gflerm/SWR-Meter/docs/AA-30_ZERO_pcb_bottom.jpg

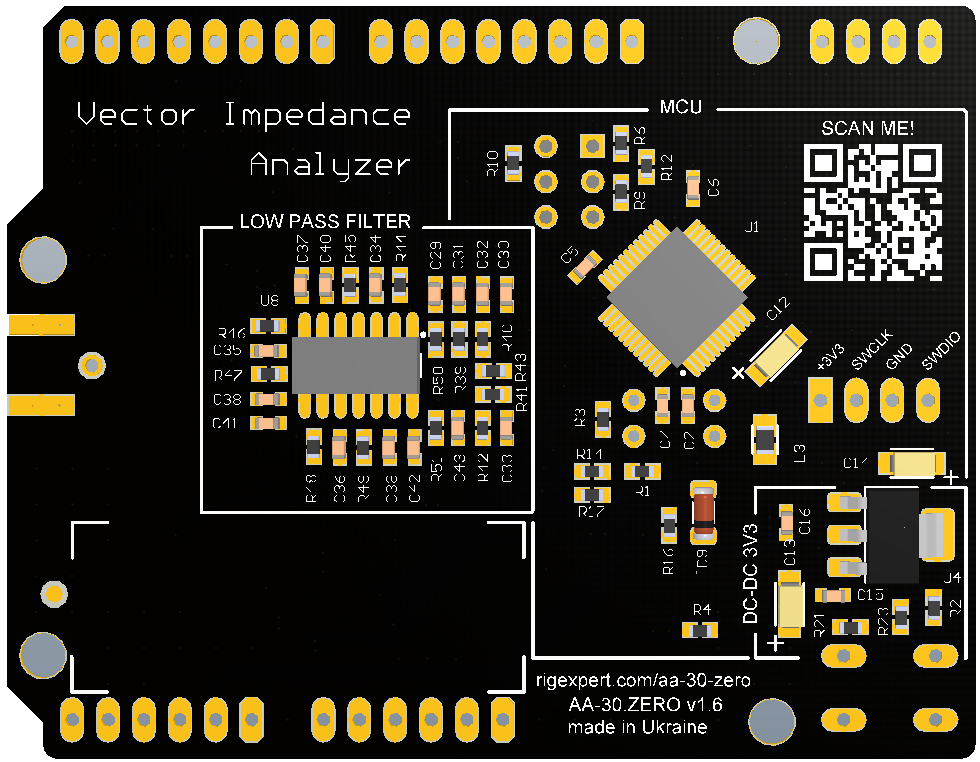
docs/AA-30_ZERO_pcb_bottom.jpg
