gflerm/SWR-Meter/docs/AA-30_ZERO_pcb_top.jpg

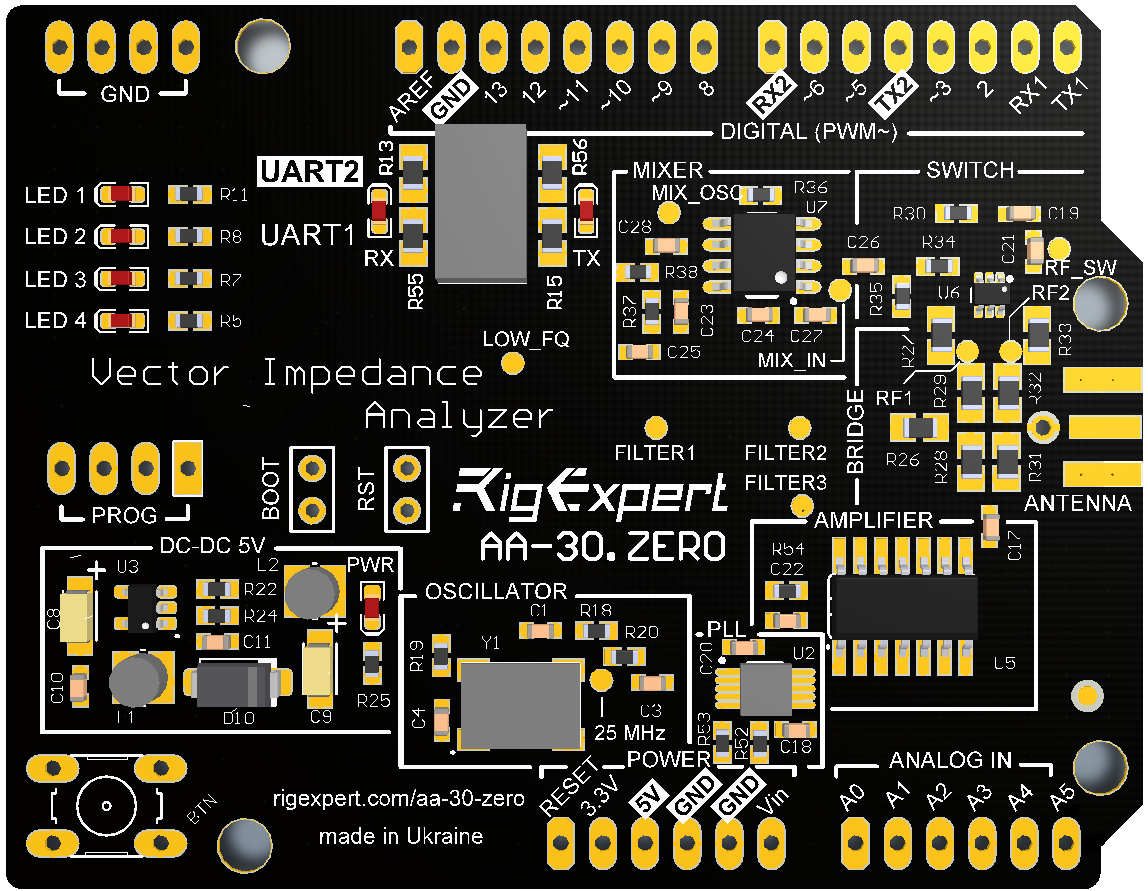
docs/AA-30_ZERO_pcb_top.jpg
