gflerm/SWR-Meter/media/screens/cal_done.png

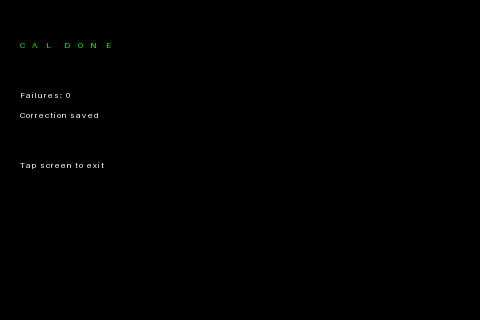
media/screens/cal_done.png
