gflerm/SWR-Meter/media/screens/cal_progress.png

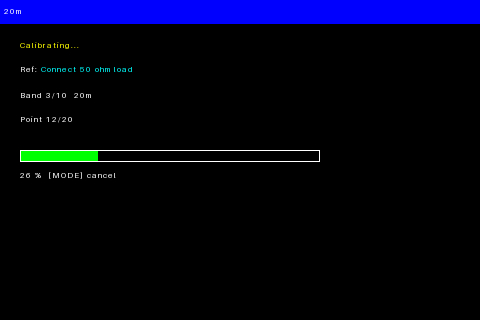
media/screens/cal_progress.png
