gflerm/SWR-Meter/media/screens/curve.png

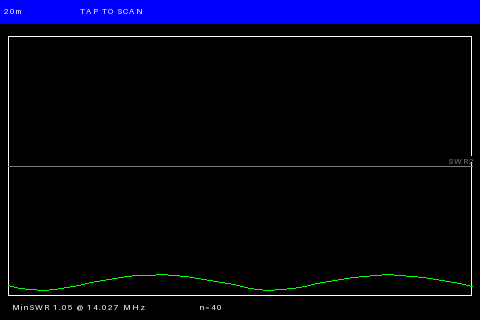
media/screens/curve.png
