gflerm/SWR-Meter/media/screens/scanning.png

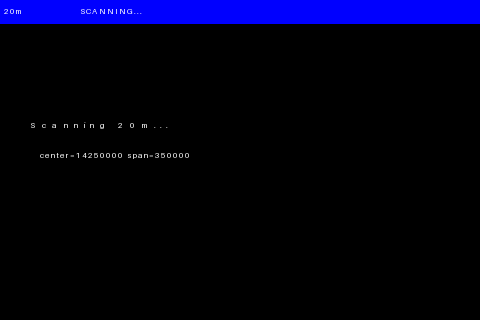
media/screens/scanning.png
