gflerm/SWR-Meter/media/screens/welcome.png

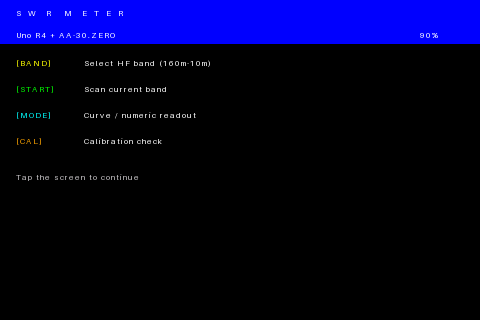
media/screens/welcome.png
