gflerm/SWR-Meter/docs/display_wiring.pdf

# Uno R4 Minima → LCDWIKI MSP4021 4.0" TFT · LiPower battery shield

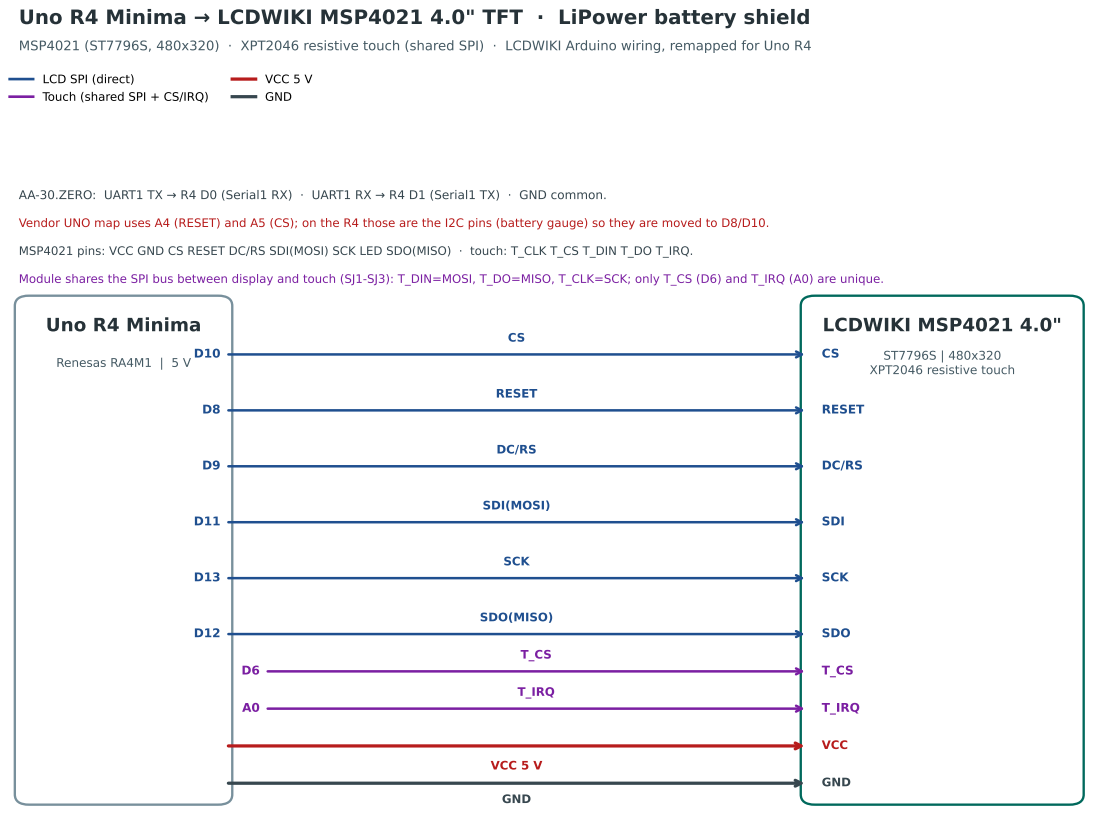
[picture p11: page 1]

MSP4021 (ST7796S, 480x320) · XPT2046 resistive touch (shared SPI) · LCDWIKI Arduino wiring, remapped for Uno R4

LCD SPI (direct)
Touch (shared SPI + CS/IRQ)

AA-30.ZERO: UART1 TX → R4 D0 (Serial1 RX) · UART1 RX → R4 D1 (Serial1 TX) · GND common.

Vendor UNO map uses A4 (RESET) and A5 (CS); on the R4 those are the I2C pins (battery gauge) so they are moved to D8/D10.

MSP4021 pins: VCC GND CS RESET DC/RS SDI(MOSI) SCK LED SDO(MISO) · touch: T_CLK T_CS T_DIN T_DO T_IRQ.

Module shares the SPI bus between display and touch (SJ1-SJ3): T_DIN=MOSI, T_DO=MISO, T_CLK=SCK; only T_CS (D6) and T_IRQ (A0) are unique.
