gflerm/SWR-Meter/graphs/12m.pdf

3.00

# RigExpert AA-30.ZERO — Antenna Analyzer Sweep

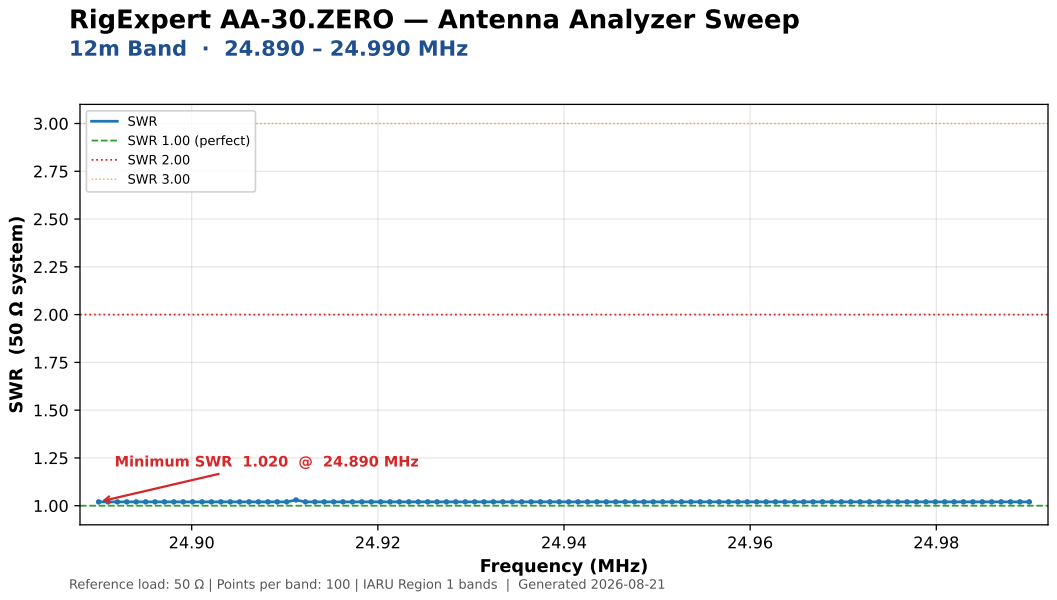
[picture p13: page 1]
Frequency (MHz); SWR (50; Ω system); Minimum; SWR 1.020 @ 24.890; MHz; 12m Band · 24.890 – 24.990 MHz

SWR
SWR 1.00 SWR 2.00 | (perfect)

SWR 3.00

Reference load: 50 Ω | Points per band: 100 | IARU Region 1 bands | Generated 2026-08-21
