gflerm/SWR-Meter/graphs/15m.pdf

3.00

# RigExpert AA-30.ZERO — Antenna Analyzer Sweep

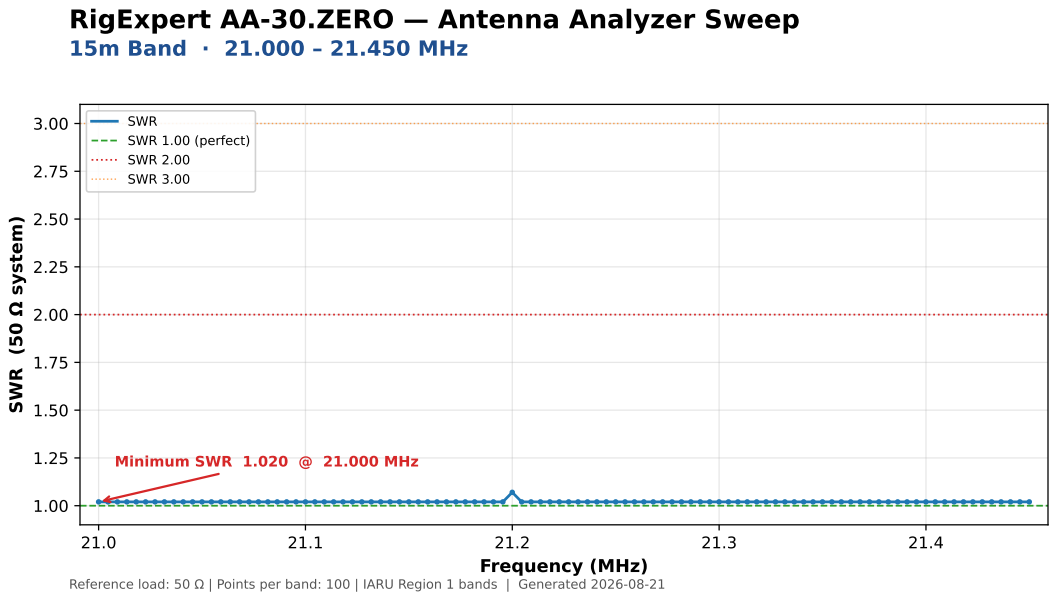
[picture p14: page 1]
Frequency (MHz); SWR (50; Ω system); 15m Band · 21.000 – 21.450 MHz

SWR
SWR 1.00 (perfect) SWR 2.00

SWR 3.00

Minimum SWR 1.020 @ 21.000 MHz

Reference load: 50 Ω | Points per band: 100 | IARU Region 1 bands | Generated 2026-08-21
