gflerm/SWR-Meter/graphs/160m.pdf

3.00

# RigExpert AA-30.ZERO — Antenna Analyzer Sweep

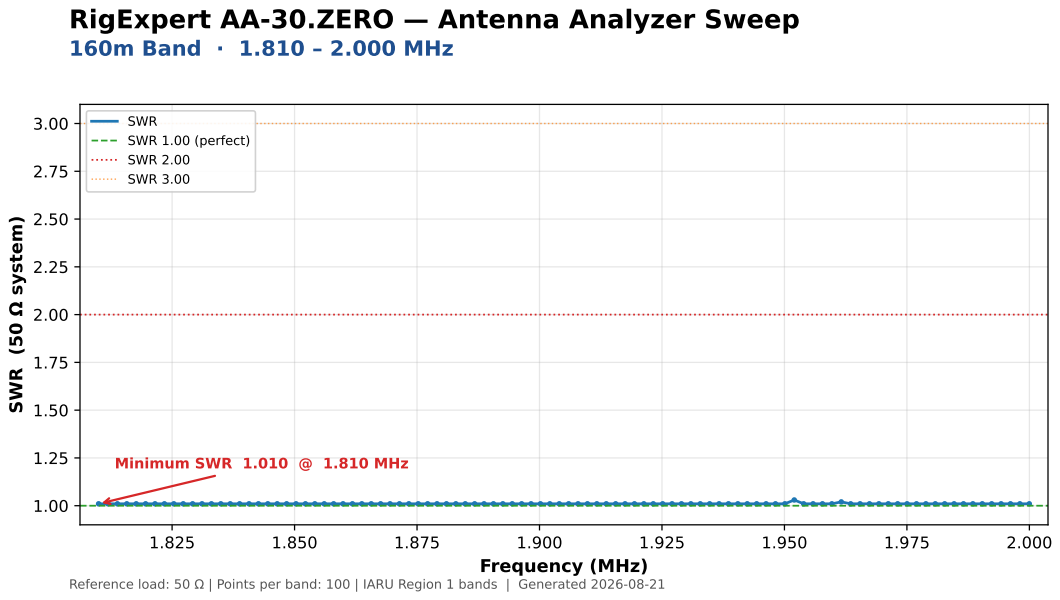
[picture p15: page 1]
Frequency (MHz); SWR (50; Ω system); Minimum SWR 1.010; @ 1.810 MHz; 160m Band · 1.810 – 2.000 MHz

SWR
SWR 1.00 (perfect) SWR 2.00

SWR 3.00

Reference load: 50 Ω | Points per band: 100 | IARU Region 1 bands | Generated 2026-08-21
