gflerm/SWR-Meter/graphs/60m.pdf

3.00

# RigExpert AA-30.ZERO — Antenna Analyzer Sweep

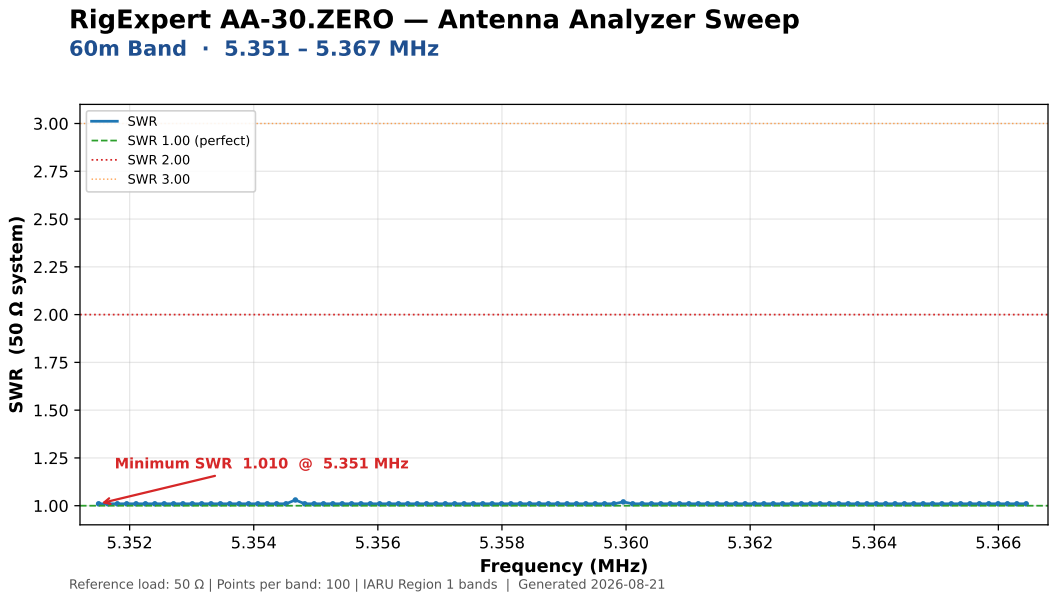
[picture p20: page 1]
Frequency (MHz); SWR (50; Ω system); 60m Band · 5.351 – 5.367 MHz

SWR
SWR 1.00 (perfect) SWR 2.00

SWR 3.00

Minimum SWR 1.010 @ 5.351 MHz

Reference load: 50 Ω | Points per band: 100 | IARU Region 1 bands | Generated 2026-08-21
