gflerm/SWR-Meter/graphs/80m.pdf

3.00

# RigExpert AA-30.ZERO — Antenna Analyzer Sweep

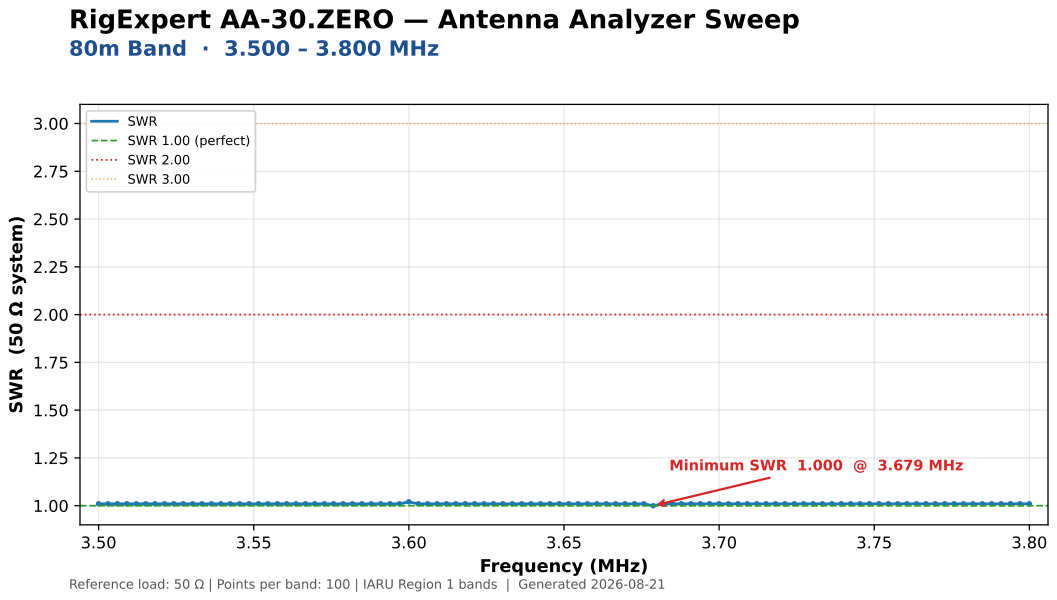
[picture p21: page 1]
Frequency (MHz); SWR (50; Ω system); Minimum SWR 1.000 @; 3.679 MHz; 80m Band · 3.500 – 3.800 MHz

SWR
SWR 1.00 (perfect) SWR 2.00

SWR 3.00

Reference load: 50 Ω | Points per band: 100 | IARU Region 1 bands | Generated 2026-08-21
