gflerm/SWR-Meter/graphs/AA-30_ZERO_all_bands.pdf

# RigExpert AA-30.ZERO

# Antenna Analyzer — Full Band Sweep

## SWR vs Frequency · 160 m → 10 m · 50 Ω reference load

Band | Frequency Range (MHz) | Min SWR | at (MHz)
160m | 1.810 – 2.000 | 1.01 | 1.810
80m | 3.500 – 3.800 | 1.00 | 3.679
60m | 5.351 – 5.367 | 1.01 | 5.351
40m | 7.000 – 7.200 | 1.01 | 7.000
30m | 10.100 – 10.150 | 1.01 | 10.100
20m | 14.000 – 14.350 | 1.01 | 14.000
17m | 18.068 – 18.168 | 1.01 | 18.072
15m | 21.000 – 21.450 | 1.02 | 21.000
12m | 24.890 – 24.990 | 1.02 | 24.890
10m | 28.000 – 29.700 | 1.02 | 28.000

### Reference load: 50 Ω | Points per band: 100 | IARU Region 1 bands

Generated 2026-08-21

3.00

# RigExpert AA-30.ZERO — Antenna Analyzer Sweep

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

SWR
SWR 1.00 (perfect) SWR 2.00

SWR 3.00

Reference load: 50 Ω | Points per band: 100 | IARU Region 1 bands | Generated 2026-08-21

3.00

# RigExpert AA-30.ZERO — Antenna Analyzer Sweep

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

SWR
SWR 1.00 (perfect) SWR 2.00

SWR 3.00

3.00

# RigExpert AA-30.ZERO — Antenna Analyzer Sweep

SWR (50; Ω system); 60m Band · 5.351 – 5.367 MHz

SWR
SWR 1.00 (perfect) SWR 2.00

SWR 3.00

Minimum SWR 1.010 @ 5.351 MHz

3.00

# RigExpert AA-30.ZERO — Antenna Analyzer Sweep

SWR (50; Ω system); 40m Band · 7.000 – 7.200 MHz

SWR
SWR 1.00 (perfect) SWR 2.00

SWR 3.00

Minimum SWR 1.010 @ 7.000 MHz

3.00

# RigExpert AA-30.ZERO — Antenna Analyzer Sweep

SWR (50; Ω system); 30m Band · 10.100 – 10.150 MHz

SWR
SWR 1.00 (perfect) SWR 2.00

SWR 3.00

Minimum SWR 1.010 @ 10.100 MHz

3.00

# RigExpert AA-30.ZERO — Antenna Analyzer Sweep

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

SWR
SWR 1.00 (perfect) SWR 2.00

SWR 3.00

3.00

# RigExpert AA-30.ZERO — Antenna Analyzer Sweep

SWR (50; Ω system); 17m Band · 18.068 – 18.168 MHz

SWR
SWR 1.00 (perfect) SWR 2.00

SWR 3.00

Minimum SWR 1.010 @ 18.072 MHz

3.00

# RigExpert AA-30.ZERO — Antenna Analyzer Sweep

SWR (50; Ω system); 15m Band · 21.000 – 21.450 MHz

SWR
SWR 1.00 (perfect) SWR 2.00

SWR 3.00

Minimum SWR 1.020 @ 21.000 MHz

3.00

# RigExpert AA-30.ZERO — Antenna Analyzer Sweep

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

SWR
SWR 1.00 SWR 2.00 | (perfect)

SWR 3.00

3.00

# RigExpert AA-30.ZERO — Antenna Analyzer Sweep

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

SWR
SWR 1.00 (perfect) SWR 2.00

SWR 3.00
