gflerm/SWR-Meter/src/config.h

// config.h
//
// Shared hardware pin map, build-time constants, and data types for the
// AA-30.ZERO SWR meter. Included by every translation unit; contains no state
// and no hardware objects, so it is safe to include from many .cpp files.
//
// 2024, opencode AI

#ifndef CONFIG_H
#define CONFIG_H

#include <Arduino.h>

// --- AA-30 ZERO UART (interface UART1, hardware Serial1: RX = D0, TX = D1)
#define AA_PORT Serial1
// PC console / telemetry port. 115200 keeps AA-30 -> PC from being the
// bottleneck while streaming many measurement points.
#define PC_BAUD 115200

// --- Display: LCDWIKI MSP4021 4.0" 480x320 TFT (ST7796S), 4-wire SPI. ---
//     Driven via TFT_eSPI, whose pin definitions are set in platformio.ini
//     (build_flags): SPI MOSI=11, SCK=13, MISO=12, CS=D10, DC=D9, RST=D8,
//     LED=D7, touch CS=D6. The module shares the SPI bus between the display
//     and the XPT2046 touch (SJ1-SJ3 jumpered). The vendor UNO map uses A4/A5
//     (RESET/CS); on the R4 those are the I2C bus (battery gauge), so the pins
//     are moved to D8/D10. Native panel is 320x480 (portrait); rotated to
//     480x320 landscape.
#define TFT_W    480  // landscape width after setRotation(1)
#define TFT_H    320  // landscape height after setRotation(1)

// --- LiPower MAX17043 low-battery alert (active-low) on D2 ---------------
#define BAT_ALERT_PIN  2     // LiPower MAX17043 ALRT (active-low)
#define BAT_LOW_PCT    32    // warn when battery drops to this % (matches alert)

// --- AA-30 signal analysis
#define Z0 50.0f                 // system impedance for SWR math (default 50 ohm)

// Validation limits for rejecting bogus readings (NaN/Inf or absurd magnitudes).
#define MAX_RESISTANCE 1000000.0f  // ohms
#define MAX_REACTANCE  1000000.0f  // ohms
#define MAX_SWR        100.0f      // physically impossible above this for HF

// Fitted line buffer for AA-30 ASCII output (one CSV line at a time).
#define LINE_BUF 96

// Device-side max points retained for display; reset on every scan.
#define MAX_POINTS 256
#define POINTS_PER_SCAN 100   // points requested per band (fits in MAX_POINTS)

// Touch hold time before a press is registered, in ms (simple debounce).
#define TOUCH_DEBOUNCE_MS 40

// If a scan or calibration sweep receives no valid data within this time,
// abort back to IDLE so the unit never hangs waiting on a silent analyzer.
#define SCAN_TIMEOUT_MS 8000

// ---- Calibration wizard / correction table ---------------------------
// The wizard sweeps every HF band against reference loads, then stores a
// per-band per-point R/X offset table in EEPROM. Normal sweeps apply the
// nearest stored offset to correct the analyzer readings.
#define CAL_PTS_PER_BAND 20   // sweep points per band during calibration
#define CAL_EEPROM_MAGIC 0x4C4E31  // "CAL1" marker
#define CAL_EEPROM_ADDR  0

// Corrections applied after a band sweep, before the band is accepted.
#define CAL_MAX_RETRIES 3   // single-point re-measures per bogus slot
#define CAL_PASS_PCT   90   // minimum % of valid points to accept a band

// ======================================================================
// DATA TYPES
// ======================================================================

struct Measurement {
  float freqMHz; // frequency (MHz)
  float r;       // series resistance (ohm)
  float x;       // series reactance (ohm)
  float swr;     // computed SWR
  bool  valid;   // passed all checks
};

// Result of a calibration / performance-check measurement.
struct CalResult {
  bool         valid;
  float        r, x, swr;
  float        devPct;   // % deviation from the reference (resistive refs)
  bool         pass;
  const char*  refName;
};

enum SystemState {
  STATE_WELCOME,
  STATE_IDLE,
  STATE_CALIBRATE,
  STATE_CAL_DONE,
  STATE_SCANNING,
  STATE_DISPLAYING
};

enum DisplayMode {
  MODE_CURVE,   // SWR vs frequency graph
  MODE_NUMERIC  // big R / X / SWR numbers
};

// IARU Region 1 HF amateur band plan (band name, low edge Hz, high edge Hz).
typedef struct {
  const char* name;
  uint32_t    low;
  uint32_t    high;
} Band;

const Band BANDS[] = {
  { "160m",  1810000,  2000000 },
  { "80m",   3500000,  3800000 },
  { "60m",   5351500,  5366500 },
  { "40m",   7000000,  7200000 },
  { "30m",  10100000, 10150000 },
  { "20m",  14000000, 14350000 },
  { "17m",  18068000, 18168000 },
  { "15m",  21000000, 21450000 },
  { "12m",  24890000, 24990000 },
  { "10m",  28000000, 29700000 },
};

#define NUM_BANDS (sizeof(BANDS) / sizeof(BANDS[0]))

// One correction entry: an additive offset to apply at a given frequency.
typedef struct {
  float freqMHz;  // measurement frequency (MHz)
  float rCorr;    // add to measured R to get corrected R
  float xCorr;    // add to measured X to get corrected X
  bool  valid;    // this point produced a physically plausible reading
} CalPoint;

// Correction table for one band (CAL_PTS_PER_BAND entries).
typedef struct {
  bool     valid;
  uint8_t  count;
  CalPoint pts[CAL_PTS_PER_BAND];
} CalBand;

// Calibration wizard phases (in order). Only the 50 ohm phase matters: it
// builds and stores the correction table. SHORT/OPEN were verification-only
// (no correction, no EEPROM write), so they were removed to keep the wizard
// to a single plug / pass.
enum CalPhase {
  CAL_PHASE_50     // sweep 50 ohm -> build offsets
};
#define NUM_CAL_PHASES 1

#endif // CONFIG_H
