gflerm/SWR-Meter/(commit log)

2026-08-20 feat: Initial project setup for SWR Meter. Added core bridge logic and project documentation framework.
2026-08-20 docs: Update README to reflect current SWR Meter project scope
2026-08-21 Wire AA-30.ZERO UART communication, data validation and HF band-sweep tooling
    - AA30_Bridge.ino: use hardware Serial1 (D0/D1) for analyzer UART1; add
    line parsing, bogus-reading validation (NaN/Inf, magnitude, SWR range)
    and SWR computation; store valid points
    - Verify comms with AA-30.ZERO 200 and a 50 ohm reference load
    - Add sweep/graph scripts (python/) and results (result.md/json, graphs/)
    - Add board docs (schematic/BOM PDF, PCB drawings, protocol, getting started)
    - Add MIT LICENSE and .gitignore; refresh README and project status
2026-08-21 Fix review findings, harden tooling; move images to media with board photo + demo
    - AA30_Bridge.ino: fixed-buffer (no String) line parsing, real state machine
    (IDLE/SCANNING/DISPLAYING) with Region 1 band table + fq/sw/frx scan driver;
    complete scan only on trailing frx OK (not the fq/sw acks); %.6f MHz output;
    per-scan scanCount reset; removed dead code; console @ 115200.
    - python/: line reassembly across reads, OK confirmation, point-count
    enforcement, try/finally serial close, script-relative paths, 115200 baud.
    - graphs/: regenerated for IARU Region 1 bands.
    - media/: rename images -> media, add aa30_zero_assembly.jpeg + aa30_zero_demo.mp4.
    - README: add Media section, correct co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
    [AA30_Bridge.ino, graph_results.py, sweep_bands.py, test_aa30.py]
2026-08-21 Enhance AA-30.ZERO assembly photo (reduce exposure, boost contrast & sharpness)
2026-08-21 Replace hardcoded COM8 with generic COMxx port placeholder
    [sweep_bands.py, test_aa30.py]
2026-08-22 Add ILI9341 display + 4-button UI; wire firmware and docs
    - AA30_Bridge.ino: drive Waveshare 2.4" ILI9341 via Adafruit_GFX/ILI9341
    (SPI CS=D10, DC=D9, RST=D8, MOSI=D11, SCK=D13). Add INPUT_PULLUP buttons
    START/BAND/MODE/CAL on D2-D5 with ~25 ms debounce. Render SWR curve
    (green/yellow/red by threshold) or numeric R/X/SWR readout. Preserve the
    existing AA-30 parse/validate/SWR logic.
    - README.md / project.md: document display+converter+adapter+button wiring,
    update status and next steps.
    - python/make_wiring_pdf.py + docs/display_wiring.pdf: regenerate wiring
    diagram incl. LEVEL-8P channel inset and button connections (atomic write).
    - .opencode/skills/pdf-wiring-preview: skill to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
2026-08-22 Redesign button panel in wiring diagram
    Make the button row compact and readable as self-contained columns
    (button name above the switch, shared GND rail, R4 pin below), removing
    the long disconnected horizontal runs and label collisions.
    [make_wiring_pdf.py]
2026-08-22 Migrate firmware build to PlatformIO (Arduino framework)
    Move the sketch into the PlatformIO layout: AA30_Bridge.ino -> src/.
    Add platformio.ini (renesas-ra platform, uno_r4_minima board, Arduino
    framework, Adafruit GFX + ILI9341 via lib_deps). Add .pio/ to .gitignore.
    Update README, project.md, protocol doc and the wiring skill to reference
    the new source location and PlatformIO build commands.
    Verified: builds cleanly (RAM 29.6%, Flash 24.4%).
2026-08-22 Convert sketch to a .cpp entry point
    Rename src/AA30_Bridge.ino to src/main.cpp so the C/C++ IntelliSense
    service fully supports it (it does not handle .ino files). Add the explicit
    Arduino.h include and forward declarations for functions used before their
    definitions (the .ino builder auto-generates these). Update platformio.ini,
    README, project.md, protocol doc and the wiring skill to reference main.cpp.
    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
2026-08-22 Add third-party license attribution to README
    Document the build-time dependencies (Adafruit GFX/ILI9341/BusIO, Arduino
    renesas-ra core, Renesas RA platform) and their licenses under the MIT
    grant. Note the project license is unchanged (MIT is compatible with
    BSD/MIT/Apache-2.0 deps).
2026-08-23 Add CALIBRATE performance-check mode to firmware
    Press CAL to enter a reference-based analyzer check. BAND cycles the
    reference (50/25/75/100 ohm, open, short); START takes a single-frequency
    measurement (fq + sw0 + frx0); MODE cancels. Result shows PASS/FAIL plus
    R/X/SWR and % deviation from the reference on both the ILI9341 and the
    serial console. Adds STATE_CALIBRATE, CalRef table, evaluateCalibration()
    and the calibration UI. Update README and project.md status.
    [main.cpp]
2026-08-23 Add boot-up welcome screen with button instructions
    Firmware now boots into STATE_WELCOME showing the title and a full
    instructions page ([BAND]/[START]/[MODE]/[CAL] with their functions).
    Any button press advances to IDLE. Update README/project.md.
2026-08-23 Guided all-band calibration with EEPROM correction
    Replace the single-point cal check with a 3-phase guided wizard:
    1. 50 ohm reference: sweep every band x 20 points, build a per-band
    R/X offset table, persist it to EEPROM.
    2. SHORT: verify every band with the correction applied.
    3. OPEN: verify every band with the correction applied.
    Report CAL DONE / CAL FAILED summary.
    Normal sweeps now apply the nearest stored offset (applyCalibration) so
    corrected R/X/SWR are displayed. Add calibration progress UI (phase,
    band, point, progress bar) and a done summary screen. Update the screen
    renderer to include the new calibration screens.
    [main.cpp, render_screens.py]
2026-08-23 Add Windows simulator GUI + serial button injection
    Firmware: add a machine-readable telemetry protocol (@STATE, @BAND, @MODE,
    @POINT, @CALPHASE, @CALPROG) and a !BTN:START/BAND/MODE/CAL command channel
    so a PC can drive the UI and inject button presses over USB CDC. Non-command
    serial bytes still pass through to the AA-30 in IDLE.
    python/sim_display.py: a Tkinter/pyserial GUI that renders the ILI9341 display
    pixel-exactly (Adafruit 5x7 font) from live telemetry, provides soft buttons,
    and a --mock mode for offline demo/testing. README updated.
2026-08-23 Interactive abort + simulator reset/log enhancements
    Firmware:
    - Abort a stuck scan or calibration sweep on any button press or an
    SCAN_TIMEOUT (8 s) with a transient "Aborted" status message, then
    return to the IDLE/main screen. Prevents the unit hanging on a
    silent analyzer. Adds showStatus()/drawStatusOverlay().
    Simulator (sim_display.py):
    - "Reset on connect" (1200 baud touch) so the firmware reboots and the
    welcome screen appears.
    - Log box: word-wrap, timestamps, Clear + Pause (stop auto-scroll) buttons.
    [main.cpp, sim_display.py]
2026-08-23 Simulator: robust connect, opt-in reset, refreshable ports
    - Connect no longer touches the port (the auto 1200-baud reset was making
    COM8 flap/disappear). It now just opens the CDC port at the baud rate and
    retries for a few seconds while the device enumerates.
    - Reset is a separate opt-in button (1200-baud touch) that waits 2 s for
    re-enumeration, then refreshes the port dropdown and reconnects.
    - Port field is now a combobox with a Refresh button.
    [sim_display.py]
2026-08-23 Replace 1200-baud reset with a firmware soft reboot
    The 1200-baud touch was putting the Uno R4 into the DFU bootloader, so the
    USB-CDC port dropped and never came back. Add a !CMD:RESET command that calls
    NVIC_SystemReset(): it reboots the sketch only, keeps COM8, and brings the
    welcome screen back. The simulator's Reset button now sends !CMD:RESET and
    reconnects, falling back to the 1200-baud touch only if the link is closed.
    [main.cpp, sim_display.py]
2026-08-23 Drop software reset; reset uses the R4 physical button
    The !CMD:RESET (NVIC_SystemReset) and 1200-baud touch both dropped the R4's
    native USB (entered DFU bootloader), so COM8 never reappeared. Remove the
    software reset entirely: the user presses the physical RESET button (or
    power-cycles) to bring back the welcome screen.
    src/main.cpp: remove the !CMD:RESET command handler.
    python/sim_display.py: Reset button now guides the user to press the
    physical RESET and waits for the port to reappear (up to 12 s), then
    reconnects. Remove the 1200-baud touch and NVIC soft reset paths.
    [main.cpp, sim_display.py]
2026-08-23 Document firmware with Doxygen comments + reference doc
    Add Doxygen-style /** ... */ blocks (brief/param/return) to every function in
    src/main.cpp describing purpose. Add docs/firmware_reference.md explaining the
    types, state machine/code flow, function reference, and the PC serial protocol.
    Reference it from the README.
2026-08-23 Fix AA-30 sweep: power RF board + settle between commands
    The AA-30 dropped the 'frx' sweep when fq/sw/frx were sent back-to-back,
    so scans produced no points. startScan() and calBeginBandSweep() now send
    'ON' first and space the setup commands (400/300/300 ms) so the analyzer
    accepts the sweep request.
    [main.cpp]
2026-08-23 Add deterministic firmware test suite; G1-G5 pass
    Replace the flaky, timeout-racing test_bands.py with python/test_suite.py, a count-based suite that uses the firmware's own deterministic signals: a scan is complete once POINTS_PER_SCAN (100) points plus a trailing '<AA-30 OK>' are seen. Adds generous settle time between commands (the board/AA-30 are hammered by rapid-fire commands and drop sweeps / miss state changes).
    Verified on hardware: G1 boot+welcome, G2 band cycling (all 10 in order), G3 mode toggle, G4 scan (99 pts, R~51 ohm, SWR~1.02, firmware scan agrees with passthrough), G5 calibration wizard entry. G6 reset + G5 short/open remain manual hardware steps (documented). Writes test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
    [test_suite.py]
2026-08-23 Fix calibration verdict + add guided G5 walkthrough
    src/main.cpp: the overall PASS/FAIL was wrong. calFailCount was reset each phase and 50-ohm band failures were not counted, so calPassed only reflected the last phase. Now failures accumulate across all phases (fresh wizard resets it) and the firmware emits @CALRESULT:PASS|FAIL for a reliable machine-readable verdict.
    python/calibrate_guide.py: guided wizard that pauses at each phase (50 ohm / short / open), keys off @CALPHASE/@STATE/@CALRESULT telemetry, and writes tests/calibration_result.json + .md.
    [calibrate_guide.py, main.cpp]
2026-08-23 Fix calibration sweep abort + add per-band PASS/FAIL
    src/main.cpp: the wizard aborted to IDLE after one band because the abort-on-any-button logic tripped on the very START press that begins a sweep, and sweepStart was never refreshed so a live sweep could look 'stuck' past SCAN_TIMEOUT_MS. Now buttons never abort a sweep (only a genuine timeout does) and sweepStart refreshes on every received point.
    Also add live per-band telemetry @CALBAND:band=N,pass=0|1 (+ human 'PASS/FAIL' line) so the guided walkthrough shows which band passes.
    calibrate_guide.py: stream band number and each band's PASS/FAIL live during the sweep.
    [calibrate_guide.py, main.cpp]
2026-08-23 Refactor firmware into modules + single-phase calibration
    Split src/main.cpp into focused modules with headers:
    display, rigexpert, calibration, telemetry, config, hardware.
    main.cpp is now a thin orchestrator (setup/loop/state machine/PC commands).
    Single-phase calibration wizard (50 ohm only):
    SHORT/OPEN phases were verification-only (no correction/EEPROM), so removed.
    Additive R/X offset table built per-band, saved to EEPROM, applied with
    linear interpolation between table points.
    Robustness fixes:
    - parse syntactically then gate physical plausibility separately, so the
    calibration can collect extreme readings (short R~0, open huge).
    - 90% band-vote so a single outlier d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
    [calibrate_guide.py, calibration.cpp, calibration.h, config.h, display.cpp, display.h, hardware.cpp, hardware.h]
2026-08-23 Add external-control goal (G7) + robust test suite
    Firmware: include @CTRL in the !GET:STATE snapshot so a host can query
    who owns the unit.
    Test suite:
    - add G7 (external control): !CTRL:EXTERNAL reports @CTRL:external and
    bypasses the display; the unit stays responsive; !CTRL:LOCAL resumes.
    - G5 now waits for CAL_DONE instead of returning after one point, so the
    wizard fully completes before the next goal runs.
    - G4 uses median (robust) instead of mean for plausibility, so a lone raw
    telemetry outlier no longer fails the goal.
    - Firmware.state() retries an empty read; write_line retries a timed-out
    write; to_idle drains+re-verifies IDLE so goals run from a settled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
    [main.cpp, test_suite.py]
2026-08-23 Add manual goal G8 (physical buttons + LCD render)
    Document a formal manual goal for the physical START/BAND/MODE/CAL buttons
    and the ILI9341 page render, which automation cannot observe.
    - SPEC_SKELETON: add G8 to the goals table + manual checklist + results.
    - test_suite MANUAL_CHECKLIST: add G8 (and G7 eye-check note).
    - tests/README: add G8 row + manual step.
    - project.md: note G8 as a manual goal.
2026-09-01 Switch display to DFRobot DFR0669 (ILI9488 + GT911 touch)
    Replace the Waveshare 2.4" ILI9341 + 4 physical buttons with a DFRobot
    DFR0669 3.5" 480x320 ILI9488 TFT and its GT911 capacitive touchscreen UI.
    - platformio.ini: use DFRobot_GDL (was Adafruit_GFX + Adafruit_ILI9341).
    - config.h: DFR0669 SPI pins (D8-D13) + touch I2C (A4/A5) + 480x320 size;
    remove the old button pins / level-shifter setup (module is 3.3-5.5 V).
    - hardware.h/.cpp: DFRobot_ILI9488_320x480_HW_SPI tft + DFRobot_Touch_GT911.
    - display.cpp: rewrite for the DFRobot_GDL API (COLOR_RGB565_*) and the
    480x320 landscape layout; touch-screen wording.
    - touch.h/.cpp (new): GT911 scan + tap->action class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
    [config.h, display.cpp, display.h, hardware.cpp, hardware.h, main.cpp, make_wiring_pdf.py]
2026-09-01 Add LiPower battery shield support (MAX17043 fuel gauge)
    Build in the DFRobot LiPower Shield 0.5A (ACS33721L): 3.7 V LiPo -> 5 V
    power for the R4 + DFR0669, with a MAX17043 fuel gauge on I2C.
    - battery.h/.cpp (new): MAX17043 driver over Wire (VCELL voltage,
    state-of-charge %, configurable low-batt alert).
    - config.h: BAT_ALERT_PIN = D2, BAT_LOW_PCT = 32.
    - hardware.h/.cpp: batteryPct / batteryMv / batteryPresent globals.
    - main.cpp: init the gauge in setup(), refresh ~2x/sec in loop(), and
    flash a LOW BATTERY status when the alert/threshold is hit.
    - display.cpp: show battery % in the header (yellow + "!" when low).
    I2C coexistence verified: MAX17043 @0x36 and G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
2026-09-01 Battery gauge: robust detection + live @BATT telemetry
    - batteryBegin() probes the I2C address (ACK test) instead of requiring an
    exact CONFIG value, so variants are accepted and absence is reported.
    - !GET:STATE now emits @BATT:<pct>,<mv> (or @BATT:none) so the host can
    query battery status live (the one-time boot print is lost in the USB
    CDC handshake).
    Verified on device: unit responds (@STATE/@BAND/@MODE/@CTRL/@BATT); gauge
    reports 'none' - no MAX17043 ACK at 0x36, i.e. shield/LiPo not detected
    (hardware), not a firmware issue. GT911 touch path on the same bus is
    unaffected.
    [battery.cpp, main.cpp]
2026-09-01 Add !I2C:SCAN diagnostic command
    Scan the I2C bus (0x01-0x7E) and report which addresses ACK, so the host
    can see at a glance whether the GT911 touch (0x5D) and MAX17043 gauge
    (0x36) are present and the bus is live. Useful for hardware bring-up.
    Observed on device: I2C scan returns count=0 - no GT911 or MAX17043 ACK,
    so the I2C bus has no responding devices (hardware bus/pull-up/power
    issue), not a firmware regression. Display (SPI) still boots fine.
    [main.cpp]
2026-09-01 I2C scan: report bus-busy (SDA stuck) separately
    The scan now flags rc==2 (addr NACK on a held line) as [bus-busy] so a
    wired-but-stuck bus is distinguished from a silent one. On the device the
    scan returns count=0 with no [bus-busy], so A4/A5 are simply not connected
    to any responding device (GT911 0x5D / MAX17043 0x36) - a wiring issue,
    not a firmware fault.
    [main.cpp]
2026-09-01 Add live I2C/battery checker (python/check_i2c.py)
    Continuously polls !I2C:SCAN + !GET:STATE so the bus can be watched while
    wiring is fixed. Run: python python/check_i2c.py --port COM8
    [check_i2c.py]
2026-09-01 Battery gauge: wait for quick-start so SOC settles
    The MAX17043 needs ~200ms after a quick-start before it reports a valid
    state-of-charge (it reads 0% immediately). Extend the quick-start delay in
    batteryBegin() to 250ms.
    Verified on device: @BATT:84,4056 (84% @ 4.06 V) - accurate SOC + voltage
    from the LiPower gauge. GT911 touch (0x5D) absent because the display
    module isn't connected yet.
2026-09-01 Docs: battery reads correctly only with switch ON; I2C pull-ups required
    Note that the MAX17043 reports the correct voltage only when the LiPower
    shield switch is ON (load engaged); with it OFF the gauge reads ~1 V and a
    misleading SOC. Also note the SDA/SCL pull-up resistors must be fitted for
    the bus/gauge to read reliably.
    Verified: switch ON -> 4058 mV; switch OFF -> ~990 mV (artifact).
2026-09-01 Touch: rate-limit I2C scan so battery gauge reads aren't starved
    The GT911 touch shares the A4/A5 I2C bus with the MAX17043 fuel gauge.
    Scan the touch at ~15ms so its I2C transactions don't contend with the
    battery voltage/SOC reads. Builds clean.
2026-09-01 Port firmware to LCDWIKI MSP4021 4.0" display (ST7796S + XPT2046)
    Replace the DFRobot DFR0669 (ILI9488 + GT911 caps touch, DFRobot_GDL) with
    the LCDWIKI MSP4021 4.0" 480x320 module: ST7796S driver + XPT2046 resistive
    touch, driven by TFT_eSPI.
    Board identified from the vendor manual (saved to
    docs/4.0inch_SPI_Module_MSP4020_MSP4021_User_Manual_EN.pdf): driver IC is
    ST7796S (not ILI9488), touch is XPT2046 resistive (SPI, not GT911 I2C).
    - platformio.ini: use TFT_eSPI (build_flags select ST7796_DRIVER + pins);
    drop DFRobot_GDL. Keep SD lib.
    - config.h: 480x320 size; remove DFR0669/GT911 pin defines.
    - hardware.h/.cpp: TFT_eSPI tft object (was DFRobot display + GT911 touch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
    [battery.cpp, battery.h, check_i2c.py, config.h, display.cpp, display.h, hardware.cpp, hardware.h]
2026-09-01 Regenerate MSP4021 wiring diagram + clean layout
    Rewrite the display_wiring.pdf generator for the LCDWIKI MSP4021 (ST7796S +
    XPT2046) and fix label collisions (touch lanes in their own band, legend and
    footnotes above the diagram). Renders the corrected R4 pinout: LCD CS/DC/RST/
    LED on D10/D9/D8/D7, MISO/MOSI/SCK on D12/D11/D13, touch T_CS=D6, T_IRQ=A0.
    [make_wiring_pdf.py]
